Monobrachius/Loconet_Master_Switch/LocoNet_EStop_V2_LN.pdf

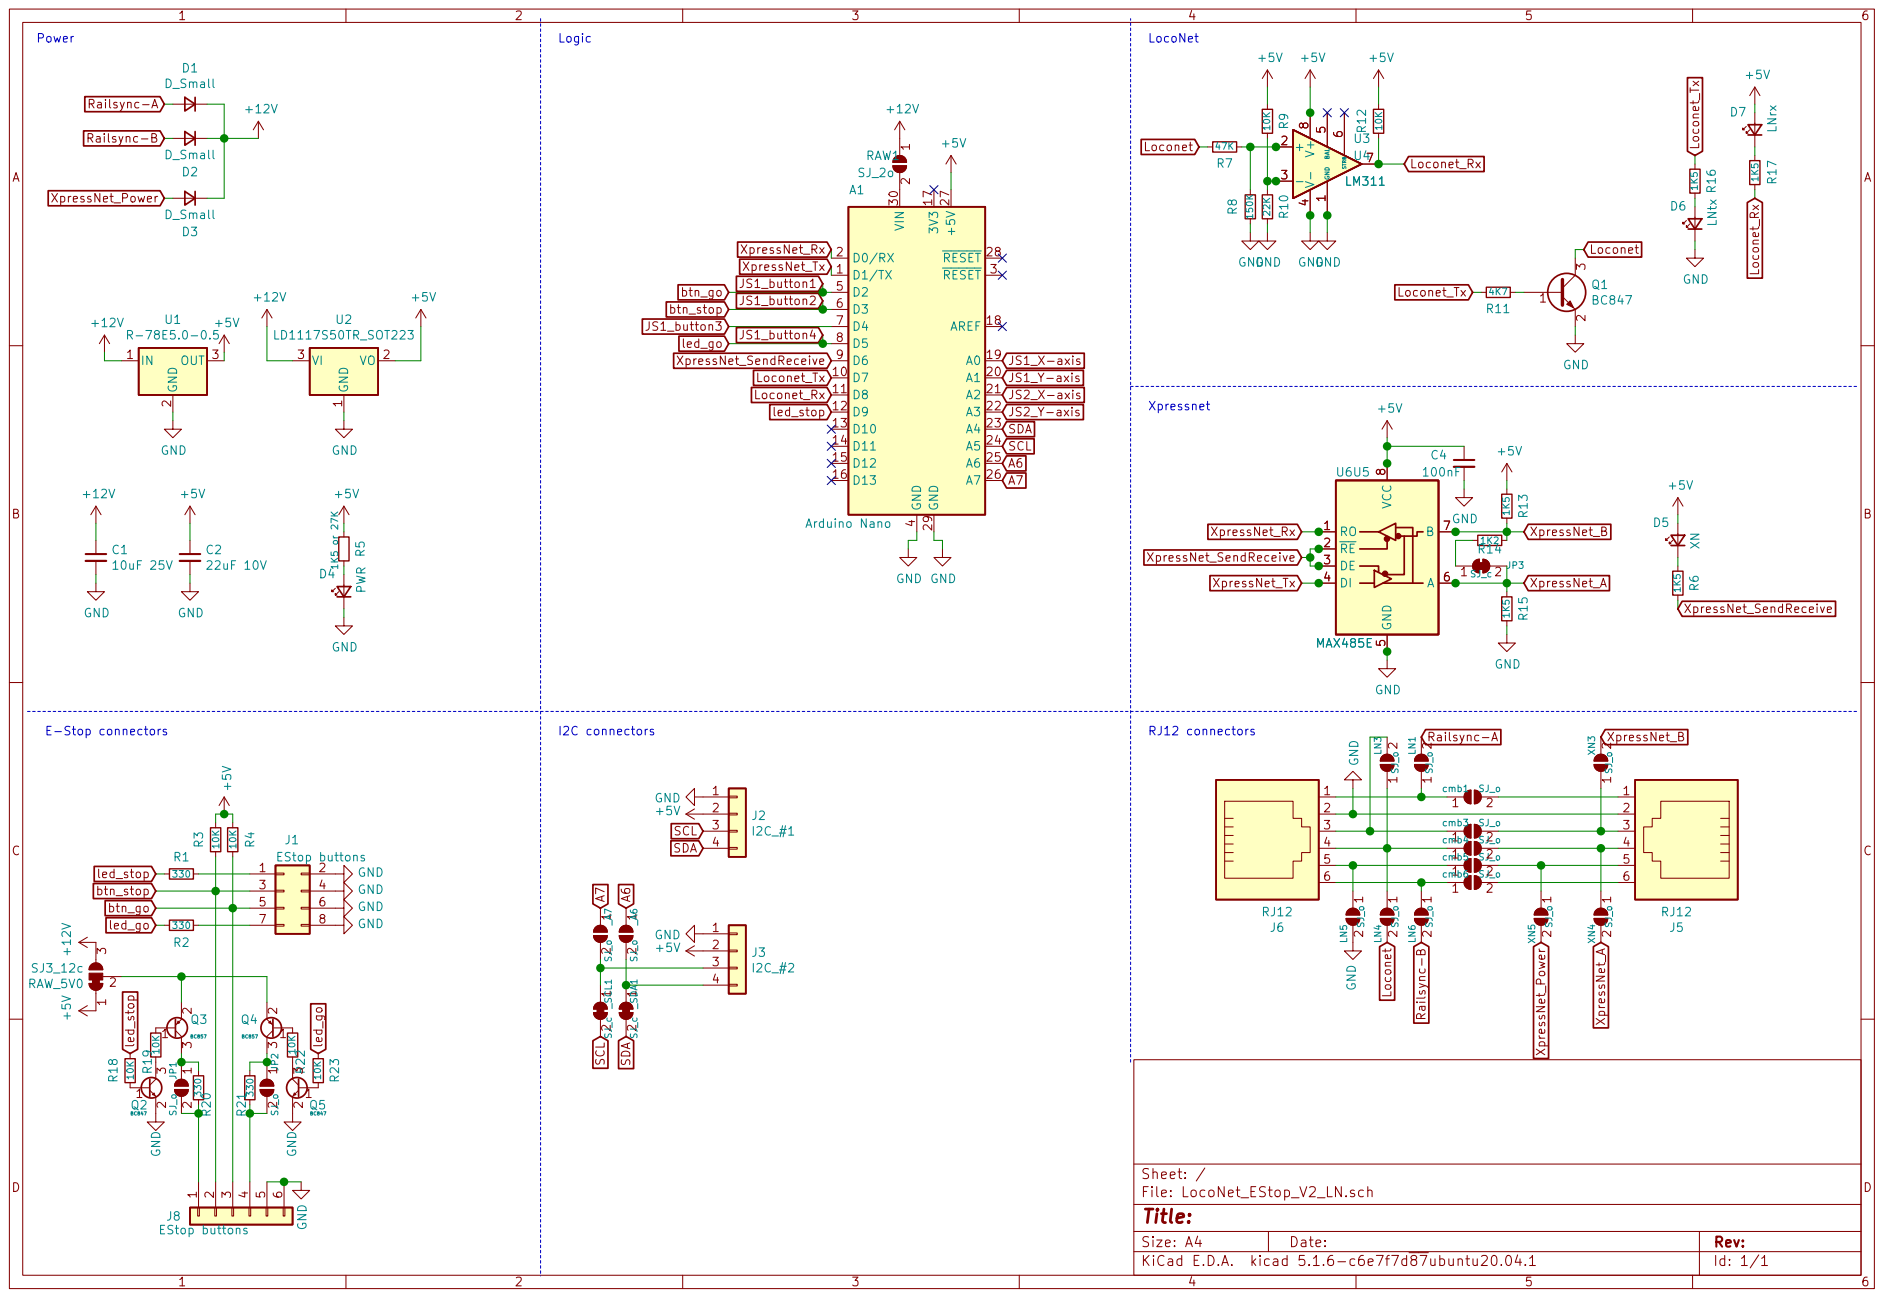
[picture p1: page 1]
