Monobrachius/Loconet_Master_Switch/(commit log)

2022-06-18 Delete LocoNet_EStop_V2.pdf
    Schematics of all options. New file is LocoNet_EStop_V2_LN.pdf and also contains more information.
2022-06-18 Update Loconet_Master_Switch_HK_V02.ino
    Clarified EStopKeptActiveWhilePushed and added more information about the type of Arduino Nano
2023-02-15 Create Soldering instructions.md
2023-02-15 Rename Soldering instructions.md to Soldering_instructions.md
